hugoferrari/heltec-sim808-gps/include/images.h

#pragma once

#include <Arduino.h>

// Imágenes monocromáticas en formato MONO/XBM: filas de arriba hacia abajo,
// cada fila ocupa ceil(ancho / 8) bytes, el bit menos significativo es el pixel
// de más a la izquierda y un bit en 1 es un pixel encendido.
// Generadas con https://www.online-utility.org/image/convert/to/MONO

// Logo Macro Intell, 128x64 (pantalla completa).
#define Logo_width 128
#define Logo_height 64
const unsigned char Logo_bits[] PROGMEM = {
	0x00, 0x00, 0x00, 0x00, 0x00, 0x00, 0x00, 0x00, 0x00, 0x00, 0x00, 0x00, 0x00, 0x00, 0x00, 0x00,
0x00, 0x00, 0x00, 0x00, 0x00, 0x00, 0x00, 0x00, 0x00, 0x00, 0x00, 0x00, 0x00, 0x00, 0x00, 0x00,
0x00, 0x00, 0x00, 0x00, 0x00, 0x00, 0x00, 0x00, 0x00, 0x00, 0x00, 0x00, 0x00, 0x00, 0x00, 0x00,
0x00, 0x00, 0x00, 0x00, 0x00, 0x00, 0x00, 0x00, 0x00, 0x00, 0x00, 0x00, 0x00, 0x00, 0x00, 0x00,
0x00, 0x00, 0x00, 0x00, 0x00, 0x00, 0x00, 0x00, 0x00, 0x00, 0x00, 0x00, 0x00, 0x00, 0x00, 0x00,
0x00, 0x00, 0x00, 0x00, 0x00, 0x00, 0x00, 0x00, 0x00, 0x00, 0x00, 0x00, 0x00, 0x00, 0x00, 0x00,
0x00, 0x00, 0x00, 0x00, 0x00, 0x00, 0x00, 0x00, 0x00, 0x00, 0x00, 0x00, 0x00, 0x00, 0x00, 0x00,
0x00, 0x00, 0x00, 0x00, 0x00, 0x00, 0x00, 0x00, 0x00, 0x00, 0x00, 0x00, 0x00, 0x00, 0x00, 0x00,
0x00, 0x00, 0x00, 0x00, 0x00, 0x00, 0x00, 0x00, 0x00, 0x00, 0x00, 0x00, 0x00, 0x00, 0x00, 0x00,
0xfe, 0x07, 0x00, 0xf8, 0x3f, 0xf0, 0x3f, 0x00, 0x0f, 0x3e, 0x78, 0xc0, 0x9f, 0x3f, 0xe0, 0x0f,
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
0xfe, 0x07, 0x00, 0xf8, 0x3f, 0xf0, 0x3f, 0x00, 0x0f, 0x0f, 0x1f, 0x1e, 0xfc, 0x7f, 0x3c, 0x3e,
0xfe, 0x07, 0x00, 0xf8, 0x3f, 0xf0, 0x3f, 0x00, 0x0f, 0x0f, 0x1f, 0x1e, 0xfc, 0x7f, 0x3c, 0x3e,
0xfe, 0x07, 0x00, 0xf8, 0x3f, 0xf0, 0x3f, 0x00, 0x0f, 0x0f, 0x1f, 0x1e, 0x3c, 0x00, 0x3c, 0x3e,
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
};
