hugoferrari/heltec-sim808-gps/src/display/display.h

#pragma once

#include "gps/gps_task.h"
#include "lora/medicion.h"

// OLED integrada del Heltec WiFi LoRa 32 V2 (SSD1306 128x64, I2C).
// Solo dibuja; qué pantalla mostrar y cuándo lo decide ui/ui.h.
// Se usa solo desde loop() (core 1).
//
// Pantalla principal:
//   Tx:-115          Rx:-98     <- medición (fuente 16)
//   SF7 SNR -3.25 #15
//   macrointell       AUTO 10s  <- gateway y modo
//   Lat: -27.468703      S:8    <- GPS (o estado: buscando / error)
//   Lon: -58.829450    H:1.1

// Imagen monocromática en formato MONO/XBM (ver include/images.h).
struct MonoImage {
    int16_t width;
    int16_t height;
    const uint8_t *bits;
};

bool displayInit();

// Dibuja una imagen MONO en el buffer, sin borrar ni actualizar la pantalla
// (permite componer con texto). `invert`: pinta los bits en 0 en lugar de los 1.
void displayDrawMonoImage(int16_t x, int16_t y, const MonoImage &image, bool invert = false);

// Borra la pantalla y muestra la imagen centrada.
void displayMonoImage(const MonoImage &image, bool invert = false);

void displayLogo();     // Pantalla de bienvenida: logo de include/images.h
void displayStartup();  // Versión del firmware

// `modoTag`: modo abreviado ("PRG", "AUTO 10s", "OFF").
// `pdrOk`: false muestra "Probando red (PDR)..." hasta el primer downlink.
void displayMain(const Medicion &med, const GpsStatus &gps, const char *modoTag, bool pdrOk);

// Pantalla de aviso: título (fuente 16) y hasta 3 líneas (fuente 10, pueden ser "").
void displayInfo(const char *title, const char *line1, const char *line2, const char *line3);

// Progreso de la pulsación larga de PRG (0.0 a 1.0) y modo al que se pasará.
void displayHoldProgress(float fraction, const char *nextMode);
