hugoferrari/heltec-sim808-gps/(commit log)

2026-10-06 Initial commit: Heltec V2 SIM808 GPS OLED
    PlatformIO project for Heltec WiFi LoRa 32 V2 reading SIM808 GNSS position via AT commands (AT+CGNSPWR / AT+CGNSINF) over UART2 (GPIO23/17) and showing it on the built-in SSD1306 OLED. Includes AT layer with timeouts, non-blocking state machine and README with wiring, power and troubleshooting.
2026-10-06 subir diagrama de conexiones
2026-10-06 Add wiring diagram to README
2026-10-06 Unify RSSI meter (LoRaWAN) with SIM808 GPS
    Merge Medidor RSSI V2.8 into the PlatformIO project. Uplink is now tx,rx,seq,sf,snr,lat,long with the last SIM808 fix (max 30 s old, else 0,0). LoRa PDR/periodic send keep the TaskScheduler scheme; GPS runs in its own FreeRTOS task on core 0. Beelan fix_classC library vendored in lib/, ABP credentials moved to ignored include/secrets.h, SX1276 DIO1/DIO2 set to Heltec V2 pins 35/34.
    [config.h, display.cpp, display.h, gps.cpp, gps.h, gps_task.cpp, gps_task.h, log.h]
2026-10-07 Add PRG button HAL and RSSI meter modes
    Button HAL (FreeRTOS task + event queue) detects single, double and long press on GPIO0. New modes: trigger with PRG (default), automatic send every 10/30/60 s (double press cycles), and send off; long press (BUTTON_LONG_PRESS_MS, 5 s) cycles modes. UI module handles main screen, mode/interval/send overlays and hold progress bar. README updated.
2026-10-08 Add splash screen with MONO logo
    Logo_bits (include/images.h, MONO/XBM format, LSB = leftmost pixel) shown at boot via ThingPulse drawXbm. New displayMonoImage/displayDrawMonoImage helpers with optional invert. README documents the image format.
    [config.h, display.cpp, display.h, images.h, main.cpp]
